ian-ross/current-sink-or-swim/README.md

# Active current sink driven by Teensy 4.0

This started as the *Current Sink Or Swim* project from [Contextual
Electronics](https://contextualelectronics.com/), but I decided to
make it programmable by adding a Teensy.
