ian-ross/current-sink-or-swim/doc/blog-articles/figures/back.png

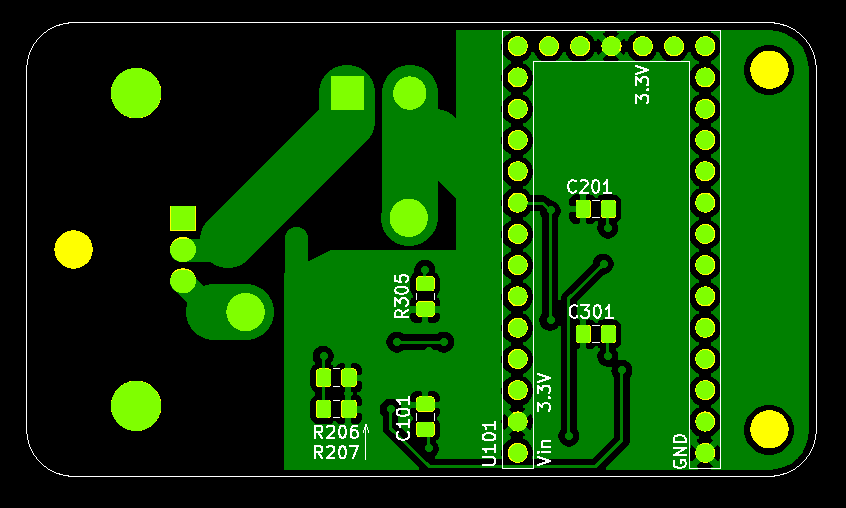
doc/blog-articles/figures/back.png
