ian-ross/current-sink-or-swim/doc/blog-articles/figures/front.png

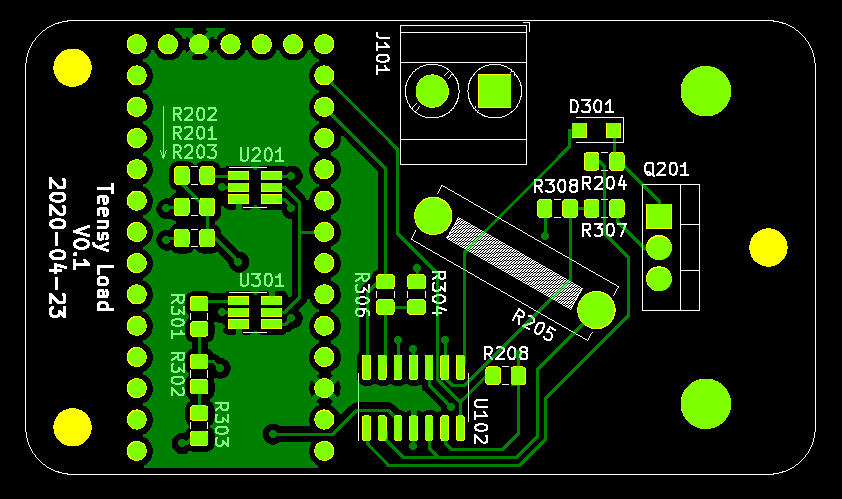
doc/blog-articles/figures/front.png
