ian-ross/current-sink-or-swim/doc/blog-articles/figures/schematics-V0.1-p3.png

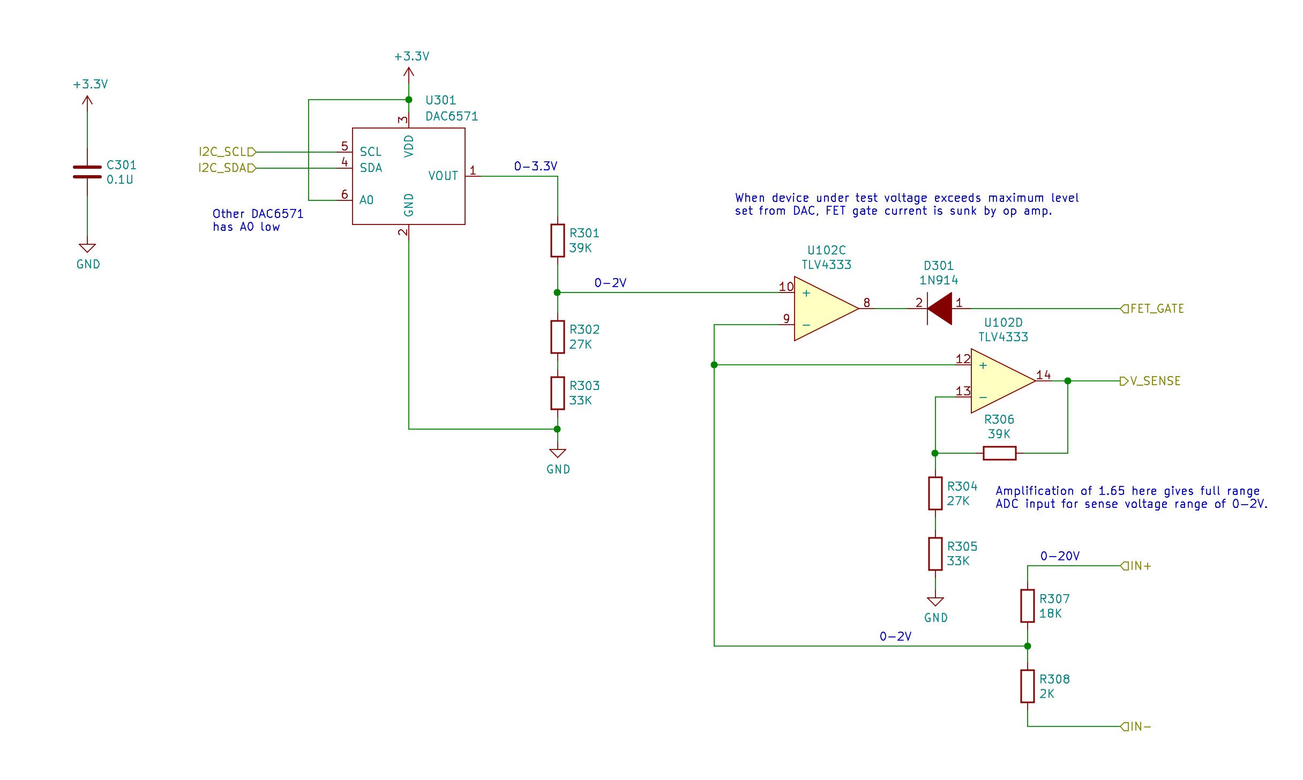
doc/blog-articles/figures/schematics-V0.1-p3.png
