ian-ross/current-sink-or-swim/doc/ce-forum/2020-03-07-schematics/01-csos.png

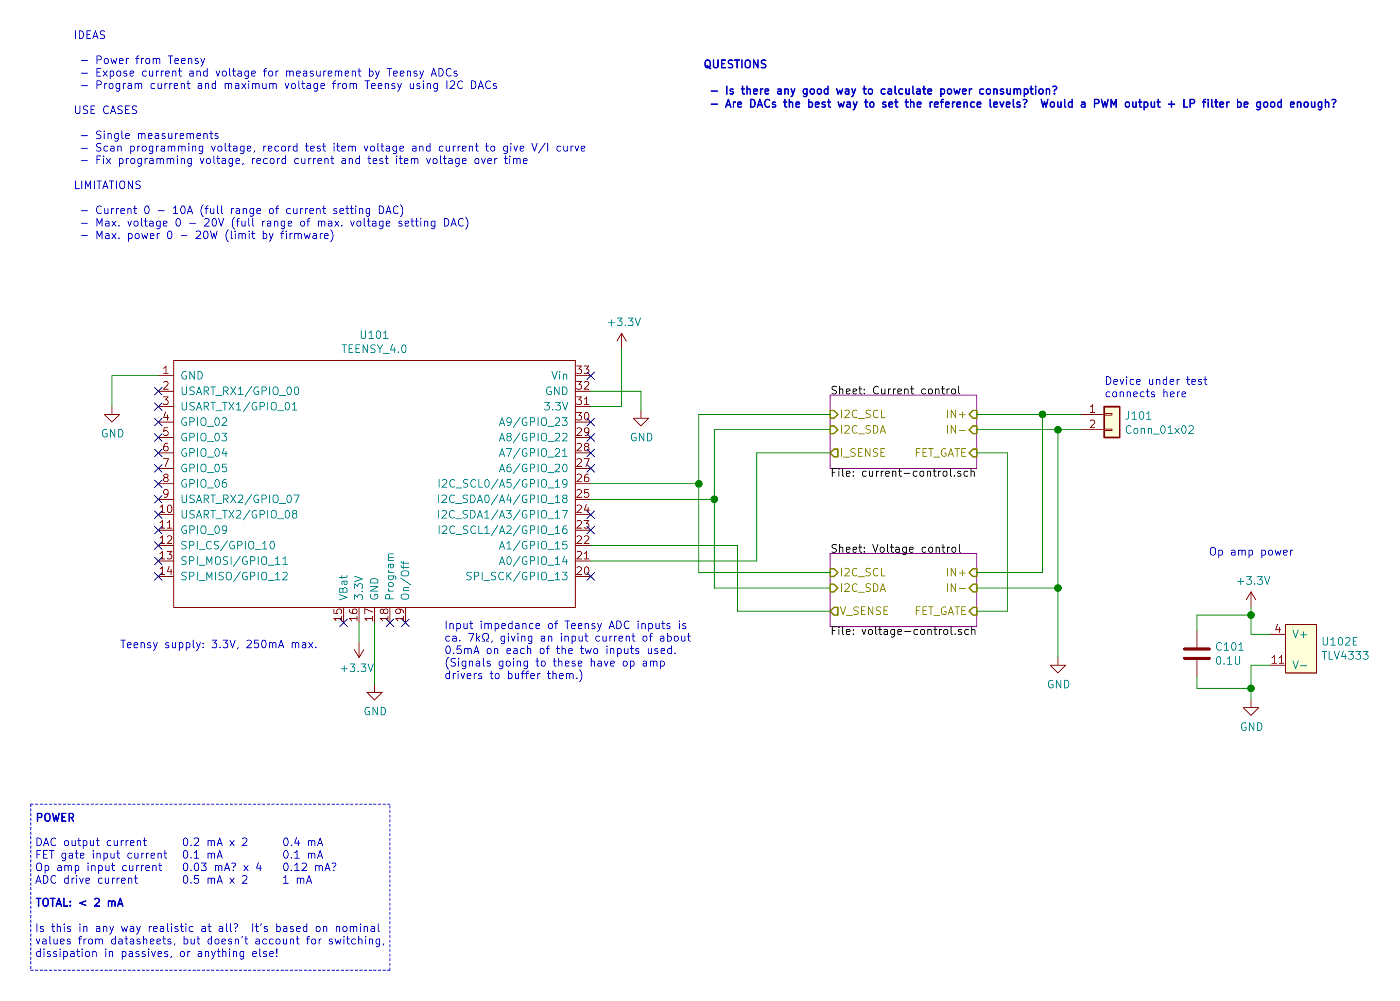
doc/ce-forum/2020-03-07-schematics/01-csos.png
