ian-ross/current-sink-or-swim/doc/ce-forum/2020-03-07-schematics/03-voltage-control.png

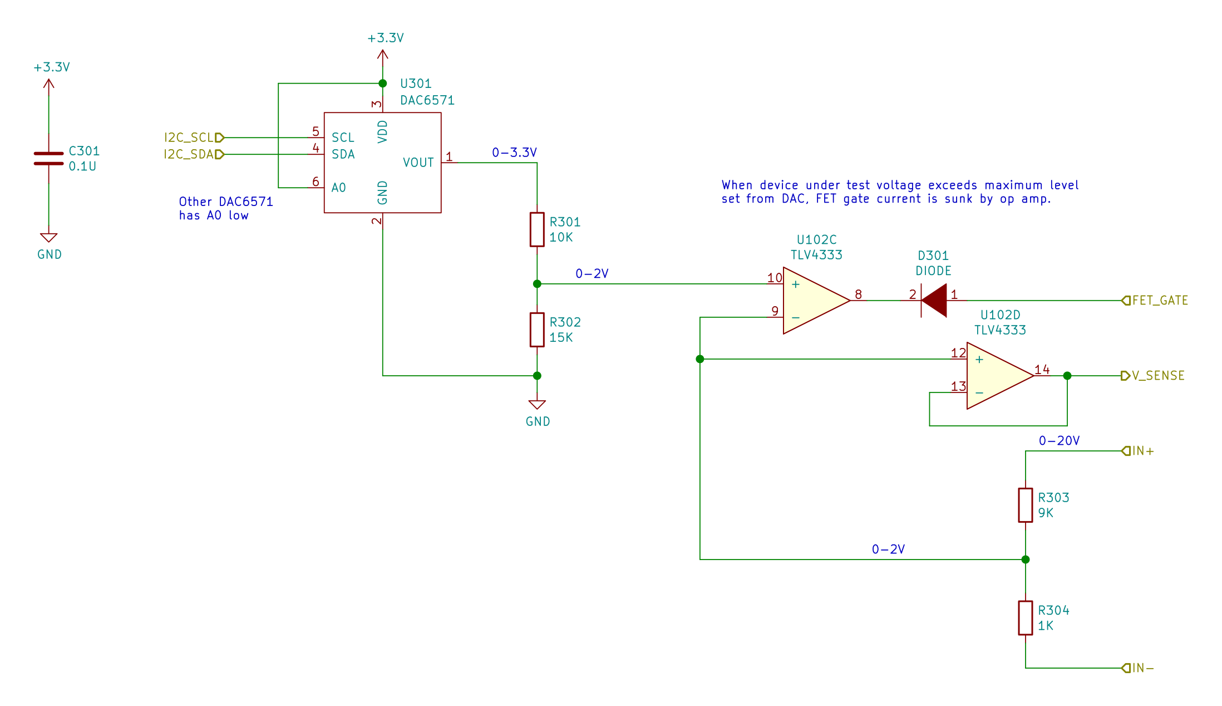
doc/ce-forum/2020-03-07-schematics/03-voltage-control.png
