ian-ross/current-sink-or-swim/doc/ce-forum/2020-04-23-layout/teensy-layout.png

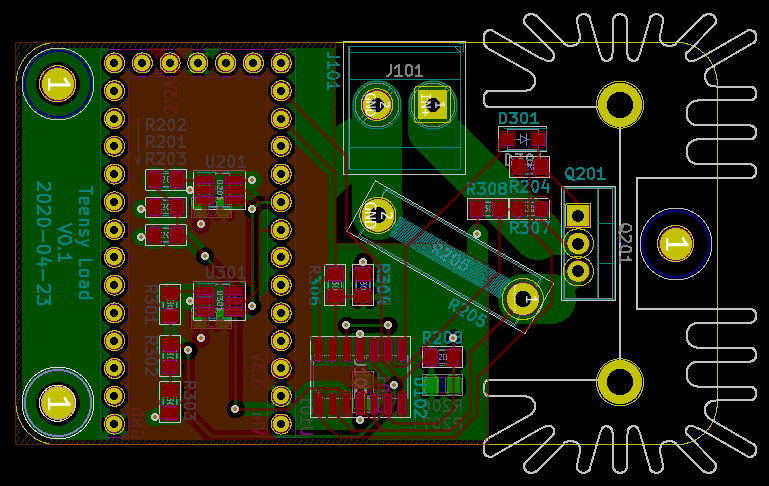
doc/ce-forum/2020-04-23-layout/teensy-layout.png
