ian-ross/current-sink-or-swim/hardware/teensy-load-bom.ods

Reference | Quantity | Value | Footprint | FP check | MPN | Datasheet
C101 C201 C301 | 3 | 0.1U | Capacitor_SMD:C_0805_2012Metric_Pad1.15x1.40mm_HandSolder | OK | 885012207098 | https://www.mouser.at/datasheet/2/445/885012207098-1727748.pdf
D301 | 1 | 1N914 | Diode_SMD:D_SOD-123F | OK | 1N914BW RH | https://www.mouser.at/datasheet/2/395/1N4148W_SERIES_K1804-1519318.pdf
J101 | 1 | Conn_01x02 | TerminalBlock_Phoenix:TerminalBlock_Phoenix_MKDS-3-2-5.08_1x02_P5.08mm_Horizontal | OK | TB010-508-02BE | https://www.mouser.at/datasheet/2/670/tb010-508-1550629.pdf
J201 | 1 | Conn_01x01_Male | teensy-load:HeatSink_RA_T2X_64E | OK | RA-T2X-64E | https://www.ohmite.com/assets/docs/sink_f_r.pdf
Q201 | 1 | BTS141 | Package_TO_SOT_THT:TO-220-3_Vertical | OK | BTS141BKSA1 | https://www.infineon.com/dgdl/Infineon-BTS141-DS-v01_00-EN.pdf
R201 R206 | 2 | 10K | Resistor_SMD:R_0805_2012Metric_Pad1.15x1.40mm_HandSolder | OK | CRGP0805F1K0 | https://www.mouser.at/datasheet/2/418/NG_DS_9-1773463-9_A-1358566.pdf
R202 R208 | 2 | 220K | Resistor_SMD:R_0805_2012Metric_Pad1.15x1.40mm_HandSolder | OK | CRGP0805F220K | https://www.mouser.at/datasheet/2/418/NG_DS_9-1773463-9_A-1358566.pdf
R203 R207 | 2 | 22K | Resistor_SMD:R_0805_2012Metric_Pad1.15x1.40mm_HandSolder | OK | CRGP0805F22K | https://www.mouser.at/datasheet/2/418/NG_DS_9-1773463-9_A-1358566.pdf
R204 | 1 | 1K | Resistor_SMD:R_0805_2012Metric_Pad1.15x1.40mm_HandSolder | OK | CRGP0805F1K0 | https://www.mouser.at/datasheet/2/418/NG_DS_9-1773463-9_A-1358566.pdf
R205 | 1 | 10m, 3W | teensy-load:Sense_Resistor | OK | RMCJ2U00R01FS | https://www.mouser.at/datasheet/2/611/rmc-series-1074317.pdf
R301 R306 | 2 | 39K | Resistor_SMD:R_0805_2012Metric_Pad1.15x1.40mm_HandSolder | OK | CRCW040239K0FKEDC | https://www.mouser.at/datasheet/2/427/crcwce3-1762584.pdf
R302 R304 | 2 | 27K | Resistor_SMD:R_0805_2012Metric_Pad1.15x1.40mm_HandSolder | OK | CRCW120627K0FKEAC | https://www.mouser.at/datasheet/2/427/crcwce3-1762584.pdf
R303 R305 | 2 | 33K | Resistor_SMD:R_0805_2012Metric_Pad1.15x1.40mm_HandSolder | OK | CRGP0805F33K | https://www.mouser.at/datasheet/2/418/NG_DS_9-1773463-9_A-1358566.pdf
R307 | 1 | 18K | Resistor_SMD:R_0805_2012Metric_Pad1.15x1.40mm_HandSolder | OK | CRGP0805F18K | https://www.mouser.at/datasheet/2/418/NG_DS_9-1773463-9_A-1358566.pdf
R308 | 1 | 2K | Resistor_SMD:R_0805_2012Metric_Pad1.15x1.40mm_HandSolder | OK | CRCW08052K00FKEAC | https://www.mouser.at/datasheet/2/427/crcwce3-1762584.pdf
U101 | 1 | TEENSY_4.0 | teensy-load:TEENSY_4.0 | OK | TEENSY 4.0 | https://www.pjrc.com/store/teensy40.html
U102 | 1 | TLV4333 | Package_SO:SOIC-14_3.9x8.7mm_P1.27mm | OK | TLV4333IDR | http://www.ti.com/general/docs/suppproductinfo.tsp?distId=26
U201 U301 | 2 | DAC6571 | Package_TO_SOT_SMD:SOT-23-6_Handsoldering | OK | DAC6571IDBVR | http://www.ti.com/general/docs/suppproductinfo.tsp?distId=26
Headers for U101 |  |  | Female headers: 2 x 14, 1 x 5
Heatsink compound
