ian-ross/current-sink-or-swim/design/3d-models/teensy.FCStd

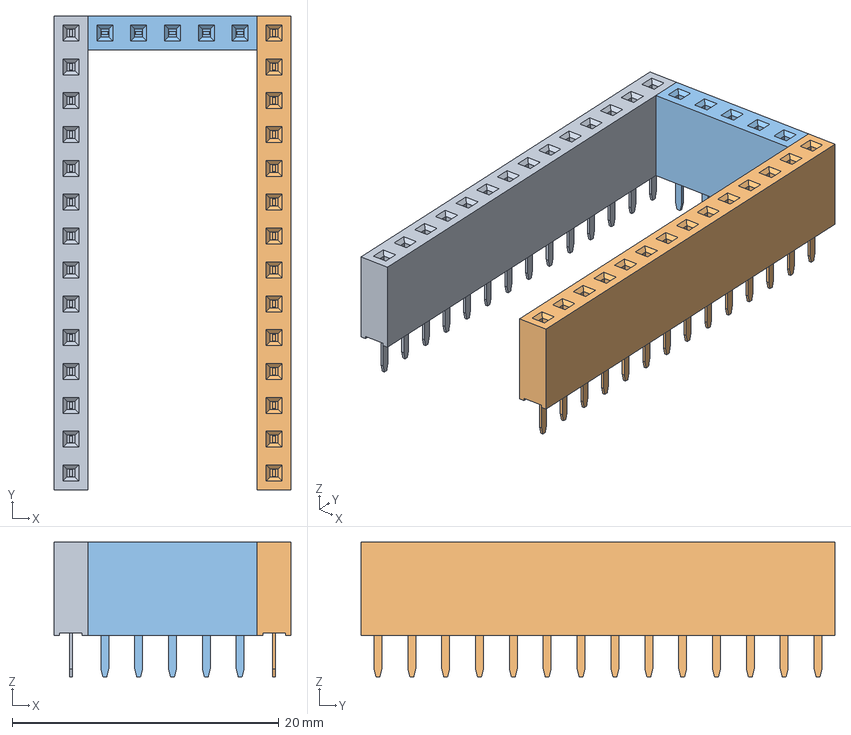
[picture p10: CAD file, 2020-03-15]
design/3d-models/teensy.FCStd
17.8 x 35.6 x 10.1 mm
PinSocket_1x14_P254mm_Vertical
PinSocket_1x14_P254mm_Vertical001
PinSocket_1x05_P254mm_Vertical
