ian-ross/current-sink-or-swim/hardware/GERBER/front.pdf

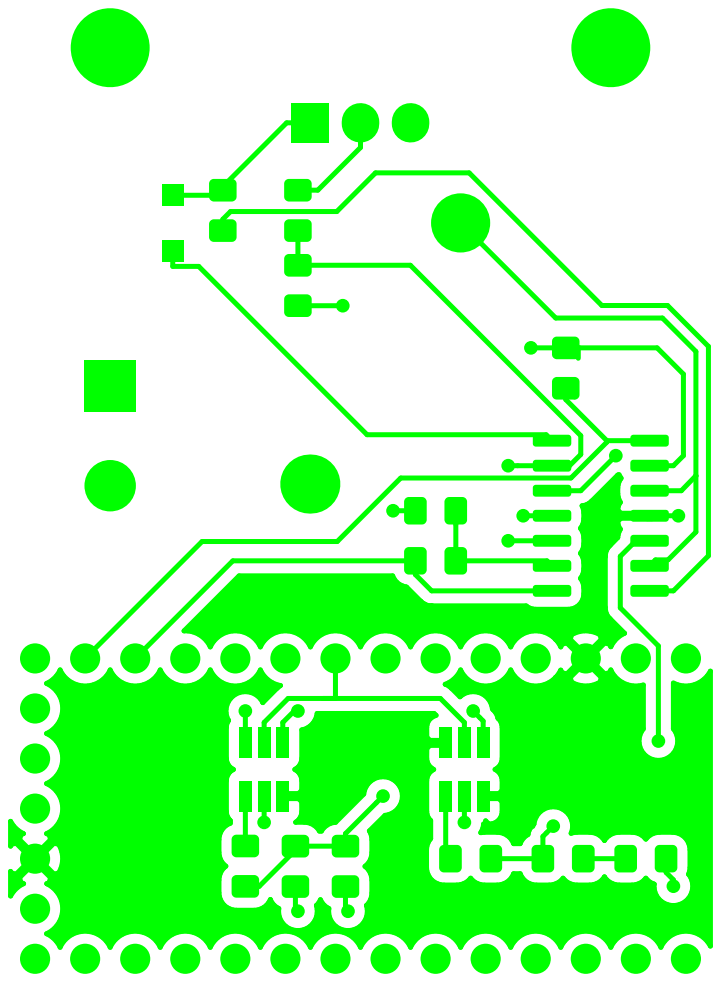
[picture p11: page 2]

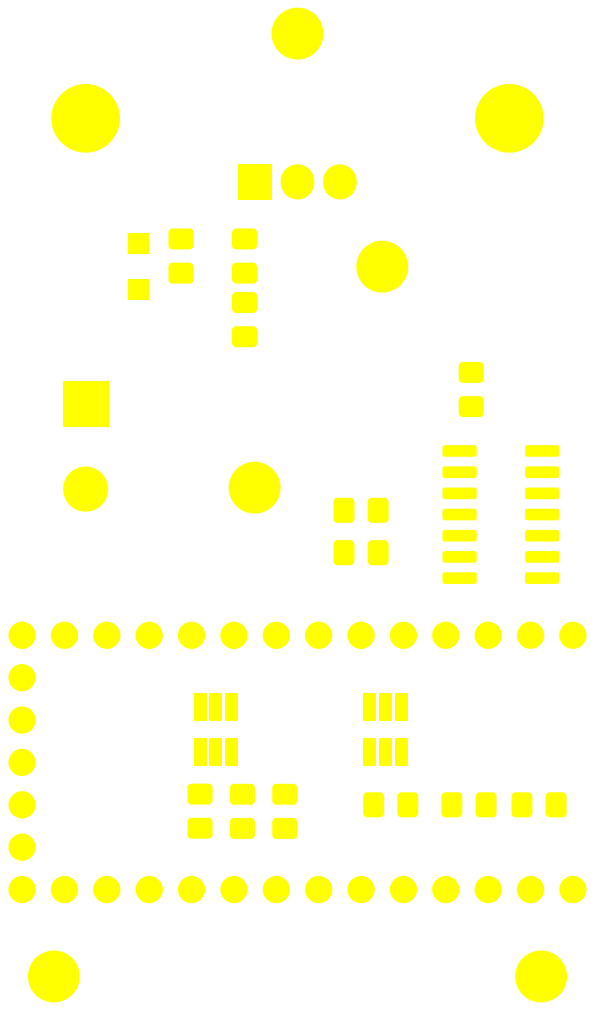
[picture p12: page 3]
