ian-ross/current-sink-or-swim/doc/blog-articles/figures/schematics-V0.1.pdf

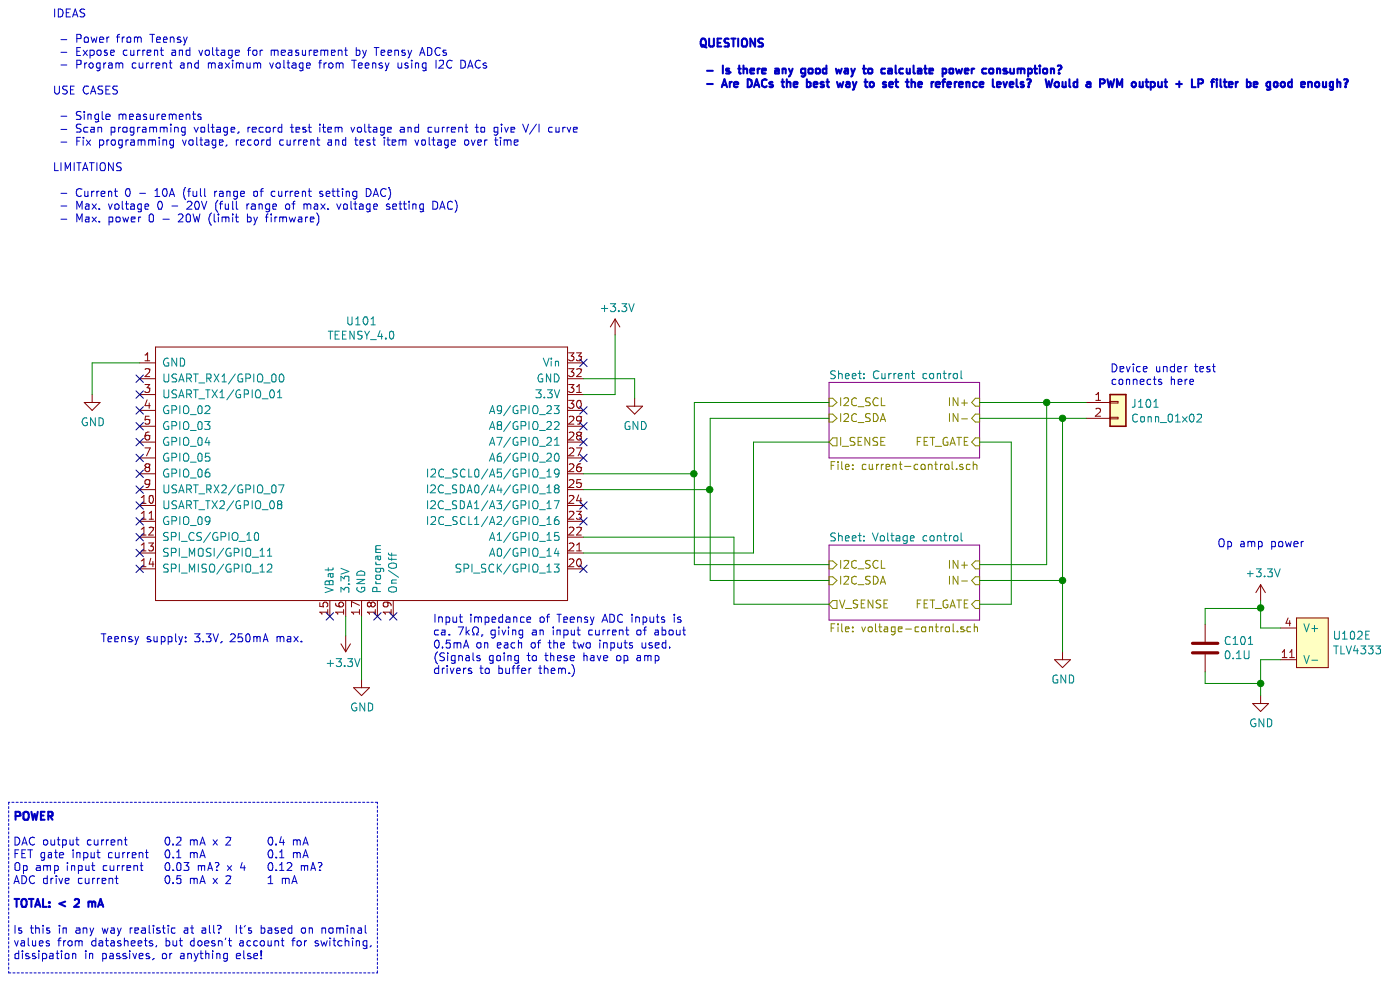
[picture p13: page 1]

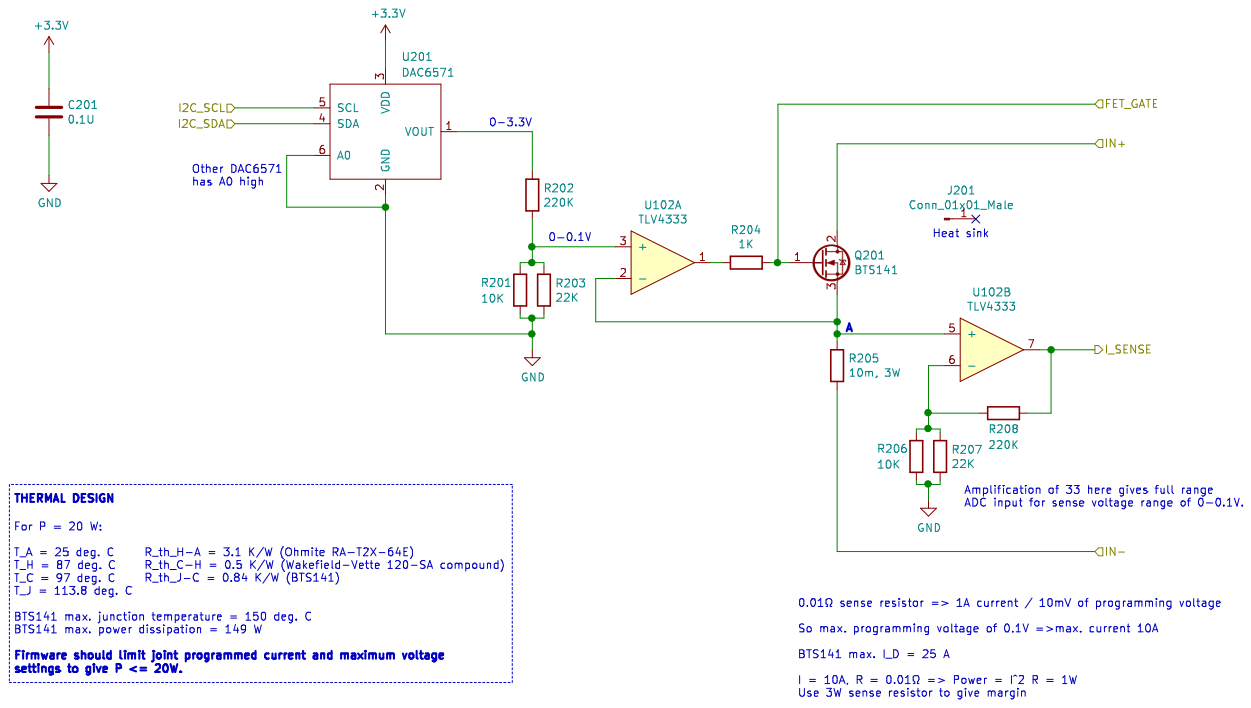
[picture p14: page 2]

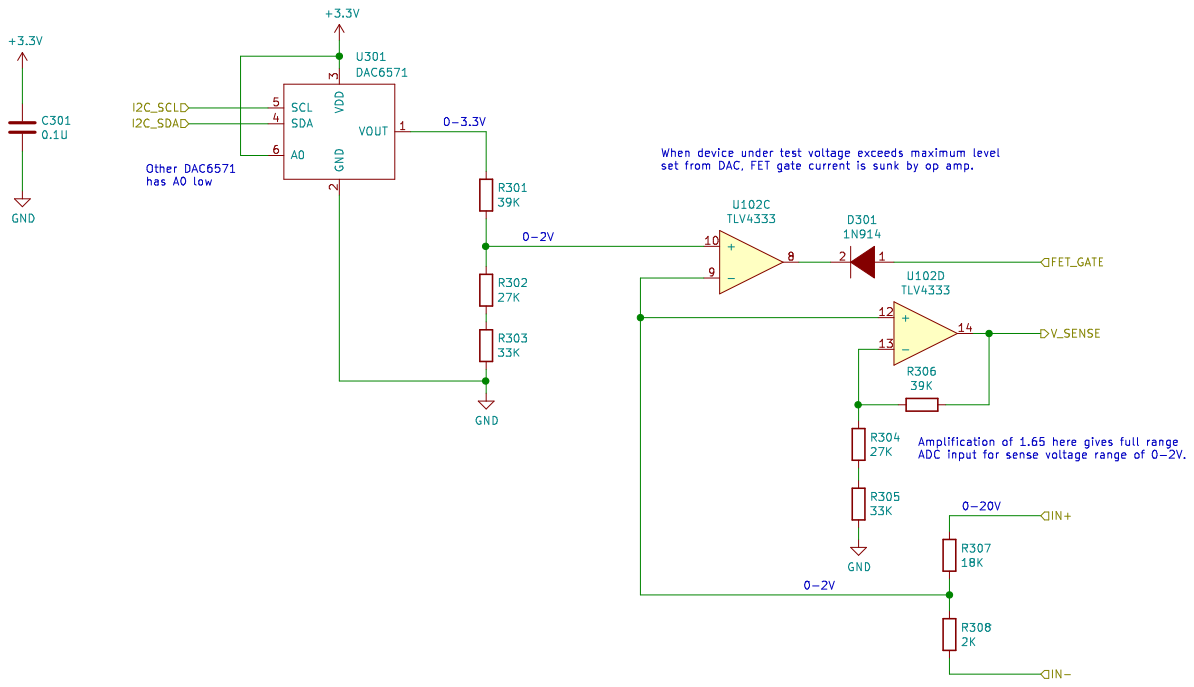
[picture p15: page 3]
