ian-ross/current-sink-or-swim/design/simulations/pwm.asc

C1: cap; 1µ
R2: res; 1K
V1: voltage; PULSE(0 3.3 0 0 0 0.5U 1U)
Named nets: 0
.tran 0 6m 0
With this setup (using a 1 MHz PWM clock), changes settle
in less than 5 ms, and the output has a ripple of less than 1 mV.
