ian-ross/current-sink-or-swim/design/simulations/simulation-1.asc

M1: nmos; 2N7002
R1: res; 1
U1: opamp
V1: voltage; 5V
V2: voltage; PULSE(1V 5V 100m 0.01m 0.01m 100m 200m 1000); Rser=10
Named nets: 0
.tran 0 1 0
.lib opamp.sub
