ian-ross/current-sink-or-swim/design/simulations/simulation-2.asc

M1: nmos; BSC010NE2LSI
R1: res; 0.1
U2: LT1218
V1: voltage; PULSE(0 0.1 0.5 0.1 0.1 0.3 1 2)
V2: voltage; 3.7V
V3: voltage; 2.7V
Named nets: 0, 2.7V
.tran 0 2 0
