ian-ross/current-sink-or-swim/hardware/teensy-load.kicad_pcb

## KiCad design hardware/teensy-load.kicad_pcb (2020-08-15)

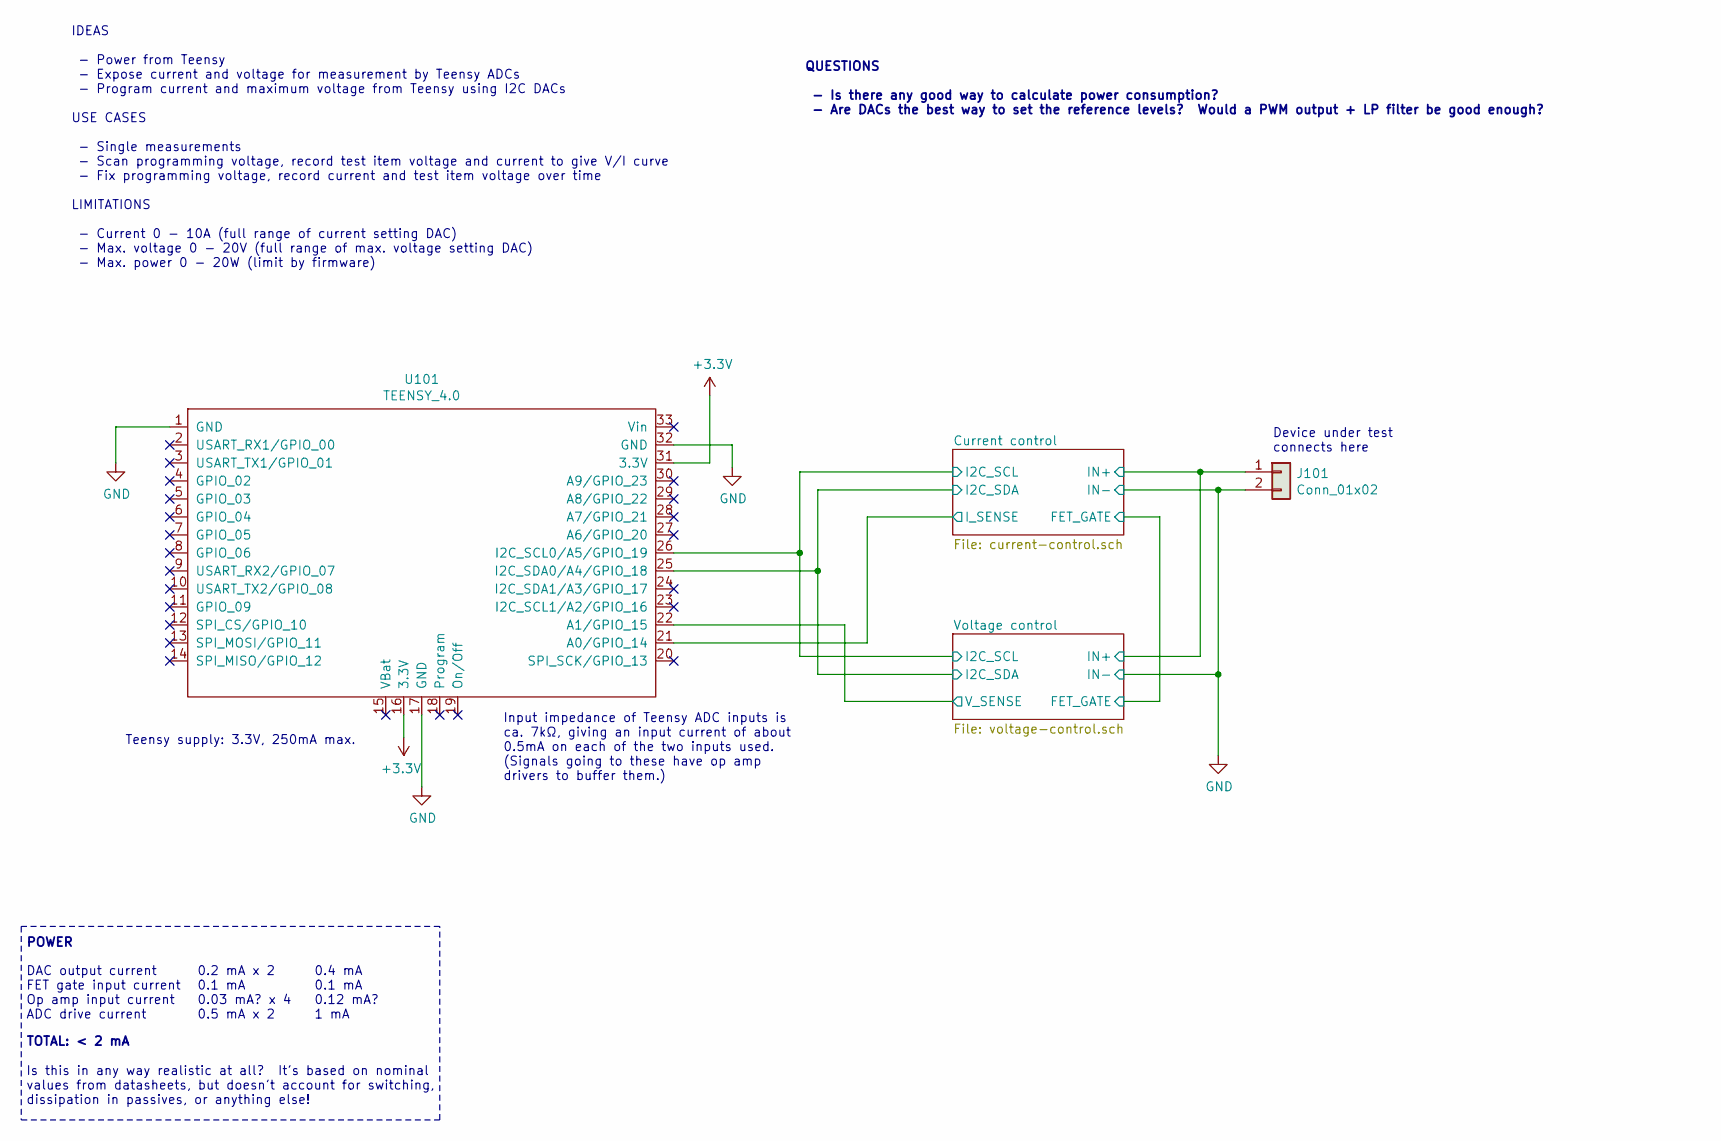
[picture p16: schematic teensy-load.sch, Programmable current sink]

Parts:
J101: Conn_01x02; TerminalBlock_Phoenix_MKDS-3-2-5.08_1x02_P5.08mm_Horizontal; MPN TB010-508-02BE
U101: TEENSY_4.0; MPN TEENSY 4.0

Connections:
+3V3: U101.16 (3.3V), U101.31 (3.3V); also elsewhere on the board
/Current control/I2C_SCL: U101.26 (I2C_SCL0/A5/GPIO_19); also elsewhere on the board
/Current control/I2C_SDA: U101.25 (I2C_SDA0/A4/GPIO_18); also elsewhere on the board
/Current control/IN+: J101.1; also elsewhere on the board
/Current control/I_SENSE: U101.21 (A0/GPIO_14); also elsewhere on the board
/Voltage control/V_SENSE: U101.22 (A1/GPIO_15); also elsewhere on the board
GND: J101.2, U101.1 (GND), U101.17 (GND), U101.32 (GND); also elsewhere on the board

Notes on the sheet:
IDEAS - Power from Teensy - Expose current and voltage for measurement by Teensy ADCs - Program current and maximum voltage from Teensy using I2C DACs USE CASES - Single measurements - Scan programming voltage, record test item voltage and current to give V/I curve - Fix programming voltage, record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
Teensy supply: 3.3V, 250mA max.
Device under test connects here
Input impedance of Teensy ADC inputs is ca. 7kΩ, giving an input current of about 0.5mA on each of the two inputs used. (Signals going to these have op amp drivers to buffer them.)
POWER
DAC output current FET gate input current Op amp input current ADC drive current
TOTAL: < 2 mA
0.2 mA x 2 0.1 mA 0.03 mA? x 4 0.5 mA x 2
0.4 mA 0.1 mA 0.12 mA? 1 mA
Is this in any way realistic at all? It's based on nominal values from datasheets, but doesn't account for switching, dissipation in passives, or anything else!
QUESTIONS - Is there any good way to calculate power consumption? - Are DACs the best way to set the reference levels? Would a PWM output + LP filter be good enough?

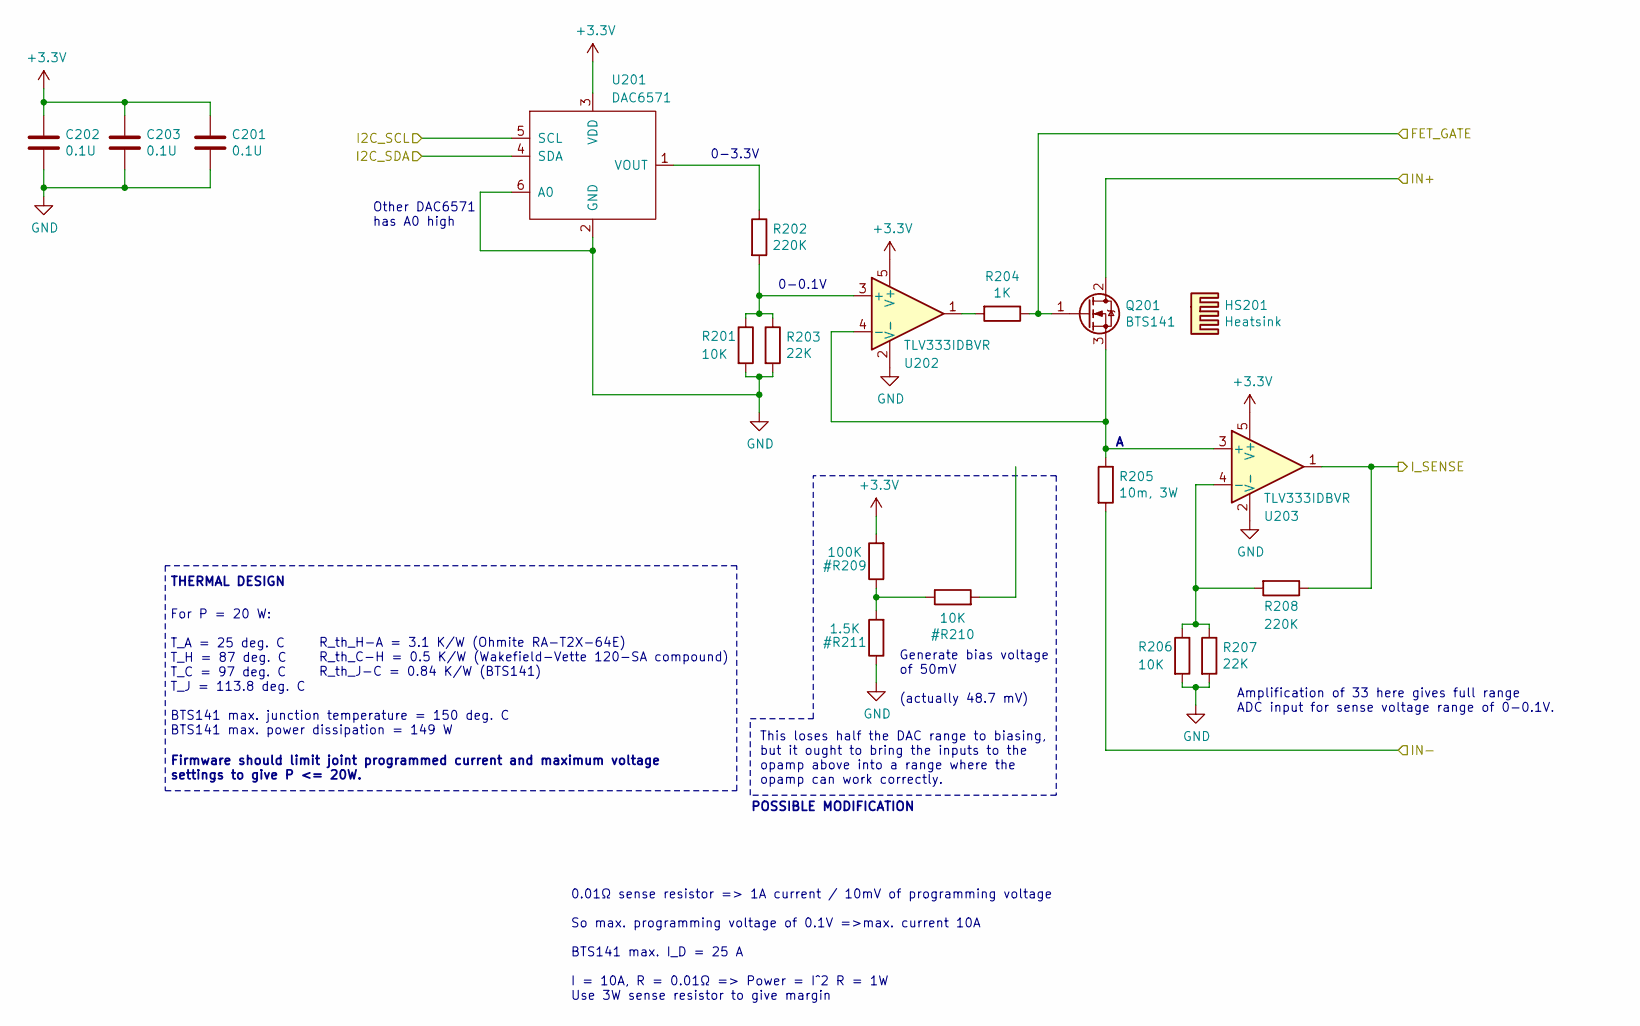
[picture p17: schematic current-control.sch, Programmable current sink (current control)]

Parts:
C201, C202, C203: 0.1U; C_0805_2012Metric_Pad1.15x1.40mm_HandSolder; MPN 885012207098
HS201: Heatsink; HeatSink_RA_T2X_64E; MPN RA-T2X-64E
Q201: BTS141; TO-220-3_Vertical; MPN BTS141BKSA1
R201, R206: 10K; R_0805_2012Metric_Pad1.15x1.40mm_HandSolder; MPN CRGP0805F1K0
R202, R208: 220K; R_0805_2012Metric_Pad1.15x1.40mm_HandSolder; MPN CRGP0805F220K
R203, R207: 22K; R_0805_2012Metric_Pad1.15x1.40mm_HandSolder; MPN CRGP0805F22K
R204: 1K; R_0805_2012Metric_Pad1.15x1.40mm_HandSolder; MPN CRGP0805F1K0
R205: 10m, 3W; Sense_Resistor; MPN RMCJ2U00R01FS
U201: DAC6571; SOT-23-6_Handsoldering; MPN DAC6571IDBVR
U202, U203: TLV333IDBVR; SOT-23-5

Connections:
+3V3: C201.1, C202.1, C203.1, U201.3 (VDD), U202.5 (V+), U203.5 (V+); also elsewhere on the board
/Current control/FET_GATE: Q201.1 (G), R204.1; also elsewhere on the board
/Current control/I2C_SCL: U201.5 (SCL); also elsewhere on the board
/Current control/I2C_SDA: U201.4 (SDA); also elsewhere on the board
/Current control/IN+: Q201.2 (D); also elsewhere on the board
/Current control/I_SENSE: R208.1, U203.1; also elsewhere on the board
GND: C201.2, C202.2, C203.2, R201.2, R203.2, R205.2, R206.2, R207.2, U201.2 (GND), U201.6 (A0), U202.2 (V-), U203.2 (V-); also elsewhere on the board
unnamed: Q201.3 (S), R205.1, U202.4 (-), U203.3 (+)
unnamed: R201.1, R202.2, R203.1, U202.3 (+)
unnamed: R202.1, U201.1 (VOUT)
unnamed: R204.2, U202.1
unnamed: R206.1, R207.1, R208.2, U203.4 (-)

Notes on the sheet:
0.01Ω sense resistor => 1A current / 10mV of programming voltage So max. programming voltage of 0.1V =>max. current 10A BTS141 max. I_D = 25 A I = 10A, R = 0.01Ω => Power = I^2 R = 1W Use 3W sense resistor to give margin
0-3.3V
0-0.1V
Other DAC6571 has A0 high
THERMAL DESIGN
For P = 20 W: T_A = 25 deg. C T_H = 87 deg. C T_C = 97 deg. C T_J = 113.8 deg. C BTS141 max. junction temperature = 150 deg. C BTS141 max. power dissipation = 149 W
R_th_H-A = 3.1 K/W (Ohmite RA-T2X-64E) R_th_C-H = 0.5 K/W (Wakefield-Vette 120-SA compound) R_th_J-C = 0.84 K/W (BTS141)
Firmware should limit joint programmed current and maximum voltage settings to give P <= 20W.
Amplification of 33 here gives full range ADC input for sense voltage range of 0-0.1V.
Generate bias voltage of 50mV (actually 48.7 mV)
This loses half the DAC range to biasing, but it ought to bring the inputs to the opamp above into a range where the opamp can work correctly.
POSSIBLE MODIFICATION

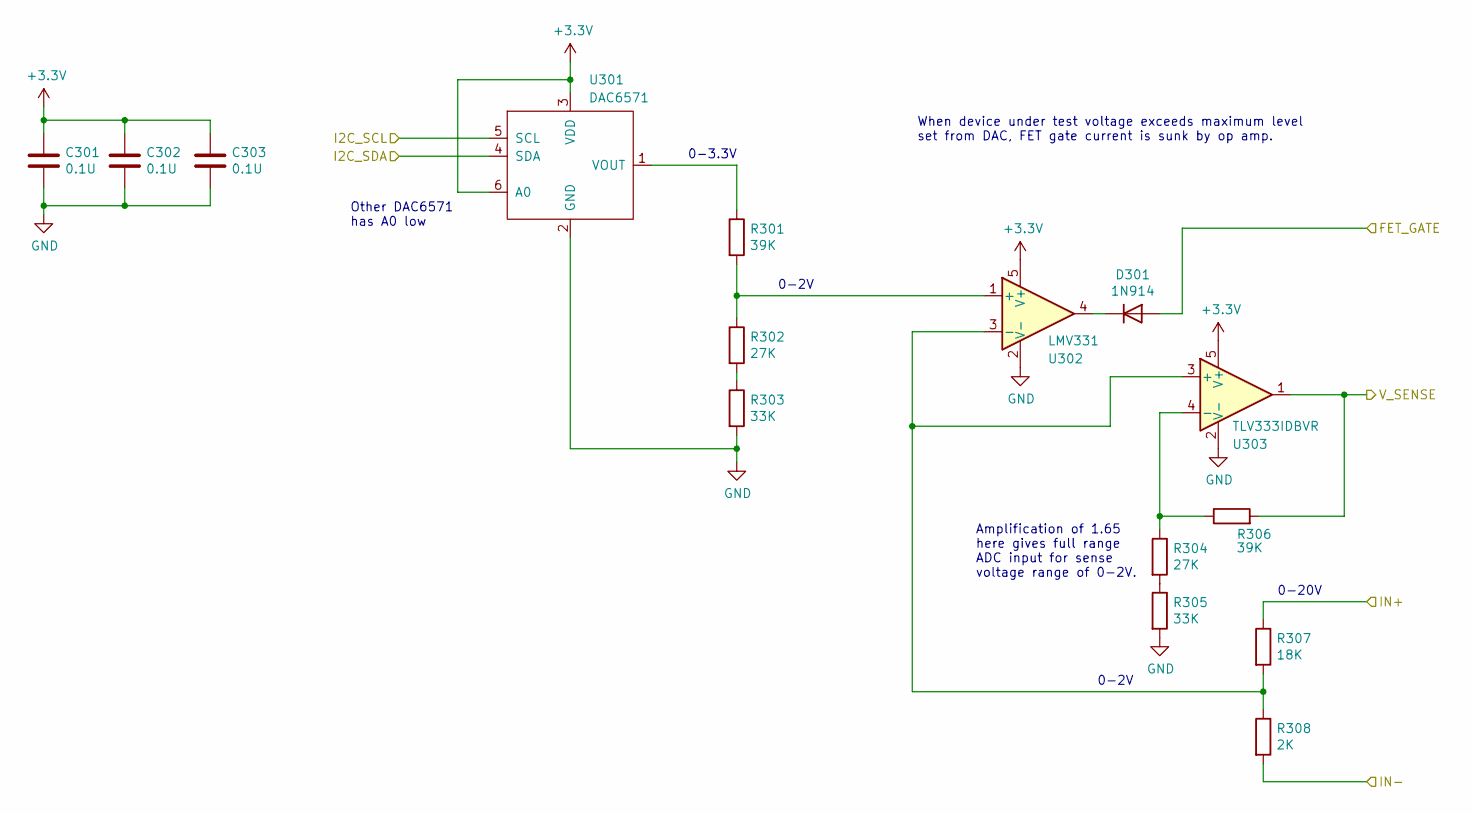
[picture p18: schematic voltage-control.sch, Programmable current sink (voltage control)]

Parts:
C301, C302, C303: 0.1U; C_0805_2012Metric_Pad1.15x1.40mm_HandSolder; MPN 885012207098
D301: 1N914; D_SOD-123F; MPN 1N914BW RH
R301, R306: 39K; R_0805_2012Metric_Pad1.15x1.40mm_HandSolder; MPN CRCW040239K0FKEDC
R302, R304: 27K; R_0805_2012Metric_Pad1.15x1.40mm_HandSolder; MPN CRCW120627K0FKEAC
R303, R305: 33K; R_0805_2012Metric_Pad1.15x1.40mm_HandSolder; MPN CRGP0805F33K
R307: 18K; R_0805_2012Metric_Pad1.15x1.40mm_HandSolder; MPN CRGP0805F18K
R308: 2K; R_0805_2012Metric_Pad1.15x1.40mm_HandSolder; MPN CRCW08052K00FKEAC
U301: DAC6571; SOT-23-6_Handsoldering; MPN DAC6571IDBVR
U302: LMV331; SOT-23-5
U303: TLV333IDBVR; SOT-23-5

Connections:
+3V3: C301.1, C302.1, C303.1, U301.3 (VDD), U301.6 (A0), U302.5 (V+), U303.5 (V+); also elsewhere on the board
/Current control/FET_GATE: D301.2 (A); also elsewhere on the board
/Current control/I2C_SCL: U301.5 (SCL); also elsewhere on the board
/Current control/I2C_SDA: U301.4 (SDA); also elsewhere on the board
/Current control/IN+: R307.1; also elsewhere on the board
/Voltage control/V_SENSE: R306.2, U303.1; also elsewhere on the board
GND: C301.2, C302.2, C303.2, R303.2, R305.2, R308.2, U301.2 (GND), U302.2 (V-), U303.2 (V-); also elsewhere on the board
unnamed: D301.1 (K), U302.4
unnamed: R301.1, U301.1 (VOUT)
unnamed: R301.2, R302.1, U302.1 (+)
unnamed: R302.2, R303.1
unnamed: R304.1, R306.1, U303.4 (-)
unnamed: R304.2, R305.1
unnamed: R307.2, R308.1, U302.3 (-), U303.3 (+)

Notes on the sheet:
0-3.3V
0-2V
Other DAC6571 has A0 low
0-20V
When device under test voltage exceeds maximum level set from DAC, FET gate current is sunk by op amp.
Amplification of 1.65 here gives full range ADC input for sense voltage range of 0-2V.

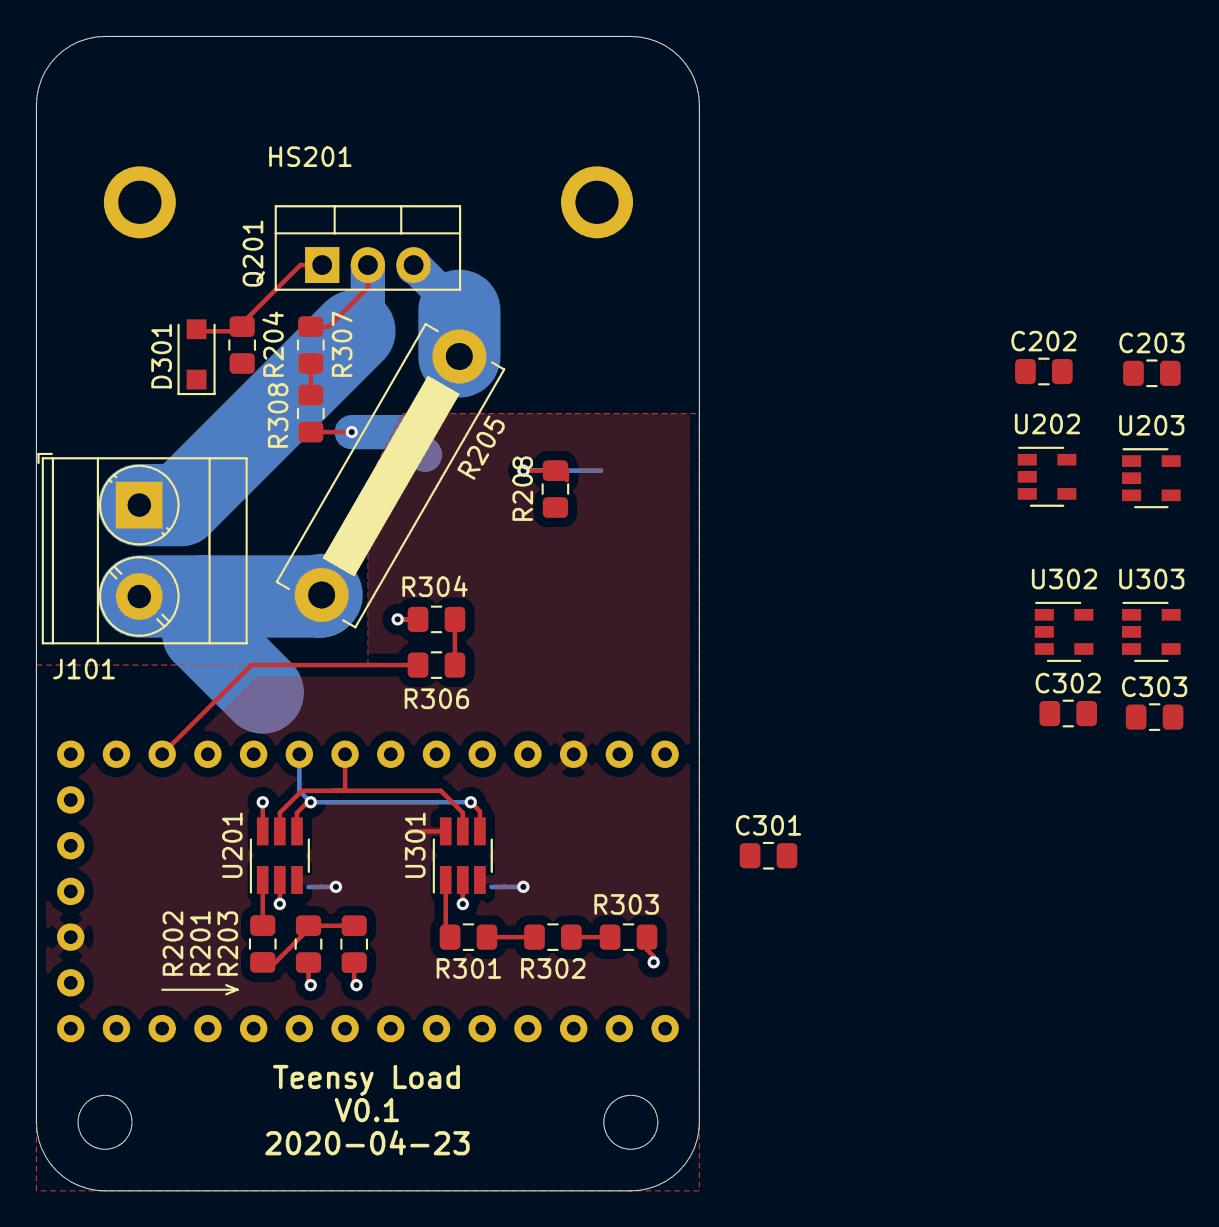
[picture p19: board teensy-load.kicad_pcb from above]

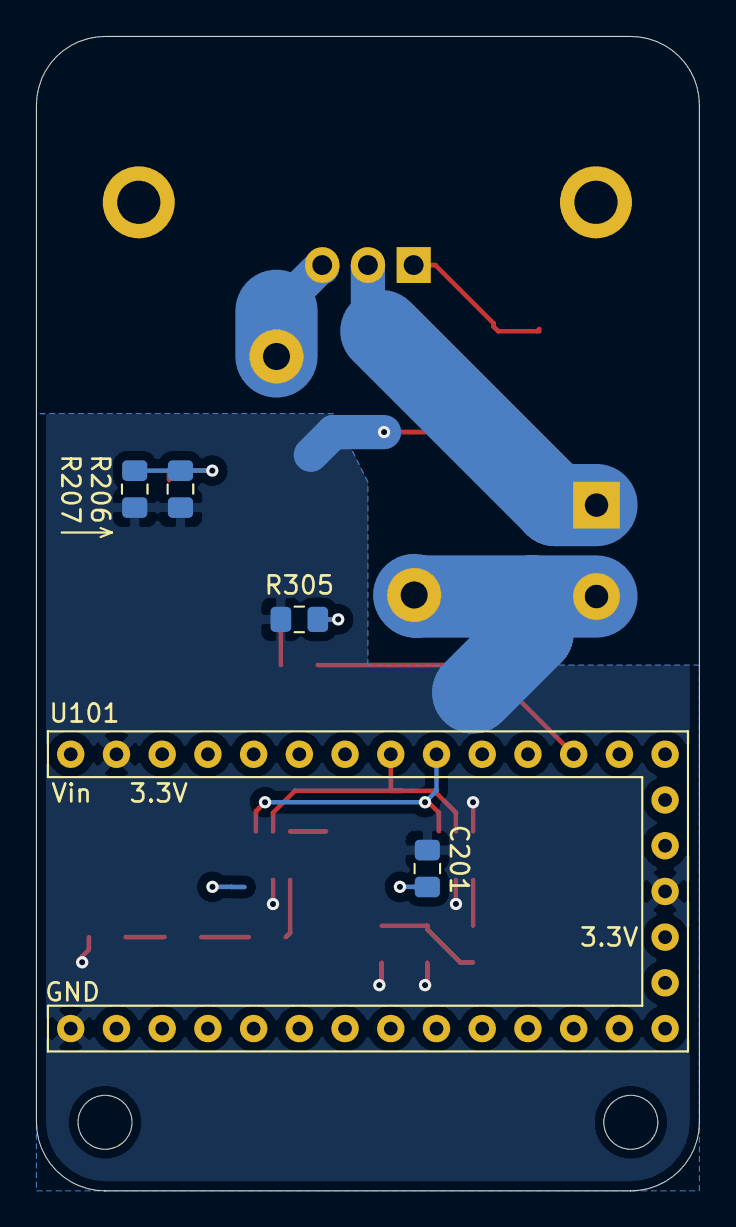
[picture p20: board teensy-load.kicad_pcb from below]

Board: 2 copper layers, 36.8 x 64.1 mm, 33 parts (5 on the bottom side), 20 nets.
