ian-ross/current-sink-or-swim/(commit log)

2020-03-15 Moving things around a little
    [current-control.sch, teensy-load.kicad_pcb, teensy-load.sch, voltage-control.sch]
2020-04-18 After footprint check, before layout
    [current-control.sch, teensy-load-bom.ods, teensy-load.kicad_pcb, teensy-load.sch, voltage-control.sch]
2020-04-22 Initial component placement
    [teensy-load.kicad_pcb]
2020-04-22 Layout done
    [teensy-load.kicad_pcb]
2020-04-23 Check-in before redoing layout
    [teensy-load.kicad_pcb]
2020-04-23 V0.1 layout for manufacture
    [teensy-load-B_Cu.gbr, teensy-load-B_Mask.gbr, teensy-load-B_SilkS.gbr, teensy-load-Edge_Cuts.gbr, teensy-load-F_Cu.gbr, teensy-load-F_Mask.gbr, teensy-load-F_SilkS.gbr, teensy-load.drl]
2020-04-23 Add V0.1 BOM
    [teensy-load-bom.ods]
2020-04-26 First draft of firmware.
    [teensy-load-bom.ods, teensy-load.kicad_pcb]
2020-07-18 Add possible biasing modification to schematic
    [current-control.sch]
2020-08-15 Calibration, tl-discharge (untested)
2020-08-15 Start of revision 2 design changes
    [current-control.sch, teensy-load.kicad_pcb, teensy-load.sch, voltage-control.sch]
